lbidulka/elec391_proj/ELEC391_Controls.pdf

## 3.5 DOF SCARA Robot Arm Controls Report

White Paper | Updated - April 13 th
, 2021.

Luke Bidulka - 62893870 ECE, University of BC, Vancouver, Canada Nikita Drozdovs - 93522522 ECE, University of BC, Vancouver, Canada Zachary Chow - 40475931 ECE, University of BC, Vancouver, Canada

Abstract
In this paper, we describe how the control system was designed and simulated for a 3.5 DOF SCARA robot arm.
Section 1 outlines the design goals and requirements. Section 2 describes the detailed controls design of the arm and its subcomponents. The first sub-section of controls is an overview and an introduction to our system. The second sub-section covers PID implementation using custom MATLAB function block, and how we calculated each of the gains. Sub-section 3 is the implementation of the whole controller in Arduino and calculating the ISR frequency, to be chosen as our Simulink sample time. The fourth sub-section explains our PID tuning strategy and the reason we chose that specific method. Sub-section 5 explains how we convert cartesian coordinates into a desired motor angle using IK, and how we convert actual motor position into cartesian coordinates using FK. Our last sub-section describes the algorithm for planning our robot’s path. Section 4 covers the performance of the design.

Nomenclature

CLK | Clock
IK | Inverse Kinematics
FK | Forward Kinematics
Kp | Proportional Gain
Ki | Integral Gain
KD | Derivative Gain

## 1. Design Goals and Overview

There were several customer specified design requirements, constraints, and goals for the control design of this robot arm outlined below. In addition, for the sake of further customer satisfaction and robustness of design in the face of unforeseen implementation challenges, several additional goals were specified.

Requirements:
- 3.5 DOF SCARA robot with wrist and gripper.
- 3 marshmallows on stopped conveyor.
| • Cylindrical (3cm Diameter x 3cm Tall). • Negligible mass & stiffness.
- 3 marshmallows discarded.

- Grab → Move 10 cm → Drop.
- 0% overshoot before gripping.

Constraints:
- 1 Arduino Leonardo.
- Motors operate at or below nominal voltage.

Goals:
- Minimum processing time

Additional Goals:

- Easily modifiable path planning and dynamic code.
- Modularity of design, to allow for different motors.
- Transferable to the real world.

## 2. Control System Design

### 2.1 Overview

The control system design was done in MATLAB and Simulink as shown in Figure 1.

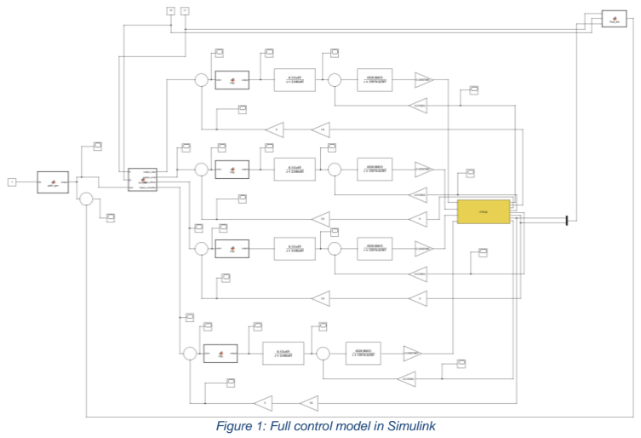
[picture p1: figure]

Figure 1: Full control model in Simulink

The system starts by generating an array of cartesian coordinates and a gripper state -either closed or open, cartesian coordinates define the path that the robot arm will follow. It then outputs those coordinates at a frequency of 0.01 seconds to the Inverse Kinematics MATLAB Function Block, which computes the desired angle in radians for the bicep, forearm, wrist, and the gripper. The desired angle is fed into its respective closed feedback loop, there we compute the motor torque and send it to SimX. In SimX we integrated a full SOLIDWORKS model instead of a simple model as our final iteration to reflect real life hardware more accurately. We also found the PID gains of both simulations to be similar but had to be slightly adjusted, thus it made sense to use the more realistic model.

### 2.2 PID Controller (MATLAB Function)

We designed our own PID controller by using a MATLAB function block. We have four different PID blocks, one for each motor, even though the motors are the same, the required proportional, integral, and derivative gains are different. Figure 2 shows an example of a PID block for the shoulder motor.

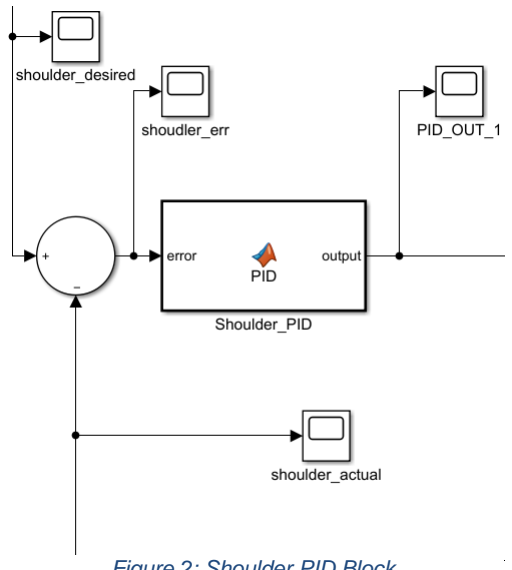
[picture p2: figure]

The input to the PID block is the error, which is just the desired position minus actual position. The code for calculating proportional, integral, and derivative values is shown in Appendix A.

### 2.2.1 PID Gain Calculations

Two of the gains were simple to calculate, for the proportional gain we just had to multiply Kp by the error, and the integral gain is just the sum of errors over time

Figure 2: Shoulder PID Block

multiplied by Ki
, however the derivative gain was bit harder to find. For the derivative gain we decided place a filtering pole and implemented this by having a running sum array that favors the most recent calculation. This was accomplished by first having an array with 4 constant gains, with each term being

(e

−Tau)

modifier∗sample_time
2 | , Tau being the derivative filter constant and modifier
being either 1,3,5 or 7, depending on the term. Then we to find the value that would be multiplied by the recently mentioned constant term, we had computed the slope of error vs sample time →
| error−(previous error)
| Δt and then multiplied it by
Kd. Every value in the running sum array would be shifted to the left by 1, and then the most recent value would be multiplied by the constant term with modifier value being 1, thus having the most impact on the derivative term.

### 2.2.2 PID output limiter

We had to make sure that the output of our PID block stays within the limit of what our motors can handle. In our code, the sum of proportional, integral, and derivative gain was limited to either 5 V or -5 V, this resulted in our motor input voltage to be below 12 V.

### 2.3 Arduino C Code

The code that would replicate the behavior of all our MATLAB function blocks was written in C and compiled in Arduino IDE, the complete code can be seen in Appendix B. In the C code we implemented features such as path planning, inverse kinematics, encoder readings and PID itself. We use the encoder to get an actual joint position, which is used to calculate the error in the PID controller. We also made use of C functionality such as structs and pointers to simplify and minimize the code. Overall, our Arduino C code behaves the same way as the MATLAB function blocks, the code just had to be slightly adjusted to be compatible with C.

### 2.3.1 ISR Frequency

For our MATLAB simulation to be as realistic as possible, we had to compute ISR frequency of our Arduino loop. Even though the Simulink model is continuous, we can specify any discrete sample time of our MATLAB function blocks, thus we can compute and output values at a predictable time interval, which is needed for our PID calculations. However, being able to choose any discrete sample time is not realistic as we need to account for how long our code in C takes to run as if we would make the device in the real world. This was done by counting clock cycles for all our executions, we found this number to be 2823 clock cycles. Our Arduino Leonardo clock frequency is 16 MHz; thus, we can divide 2823 by 16 MHz, and we get 0.000176 seconds, this is our supposed

MATLAB sample time. However, we found that to be too fast to control and we were not able to get a zero-error steady state, thus we added a delay in the Arduino code for 823 Microseconds and brought our sample time down to 0.01 seconds.

### 2.4 Tuning Strategy

We used the same tuning strategy for all our joints and the steps were as follows:
1. Pick a constant destination value, for example go from [0.2 0.15] -> [0.15 0.3]
2. Make all the PID gains equal to zero.
3. Increase Kp to as large as possible while staying within our PID output limit and the error should have as close to steady oscillations as possible, see Figure 3.
a. Note: Our PID output limit is 5 and -5, so that we stay below 12 V as an input to the motors

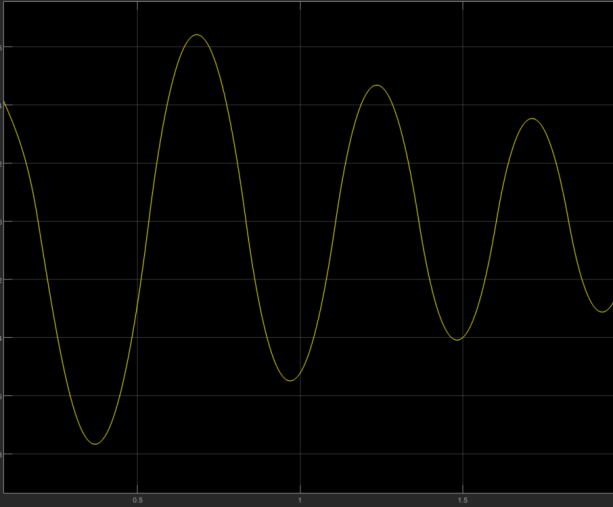
[picture p3: figure]

4. Increase KD until the oscillations go away, so it is critically damped, see Figure 4.

Figure 3: Shoulder Error, Kp=3

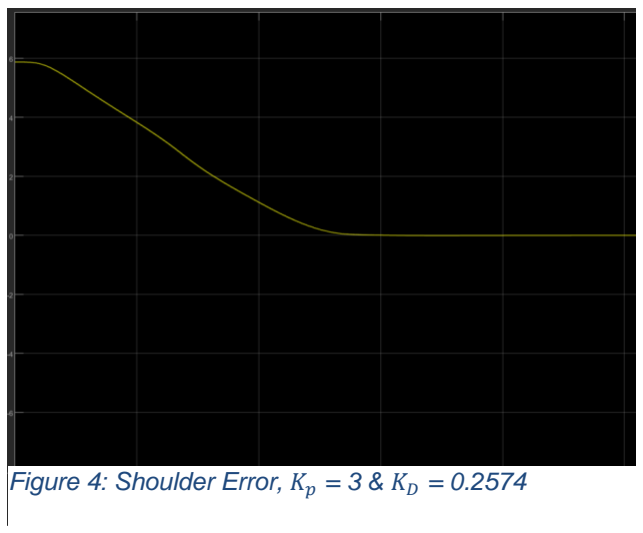
[picture p4: figure]

Figure 4: Shoulder Error, Kp = 3 & KD = 0.2574

5. Look at PID output and if it is below 5V, try to increase Kp and KD and see if we can get critically damped faster.
6. Slightly start increasing Ki until it brings us to our desired setpoint with the number of oscillations desired.
7. Figure 5 shows our final result.

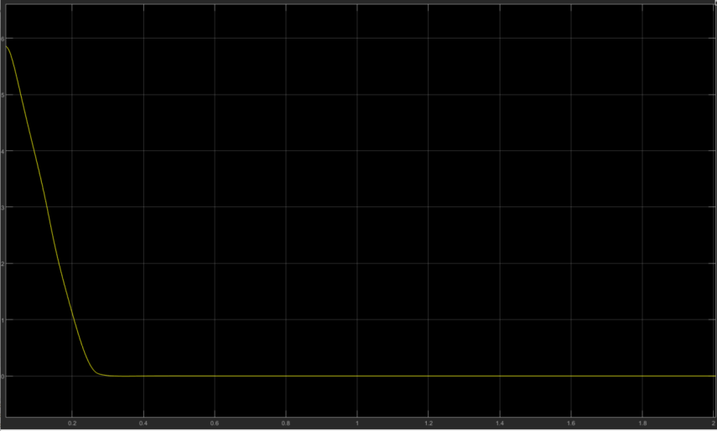
[picture p5: figure]

We decided to use this tunning strategy over the one introduced in class, because we found it more time efficient to co-simulate Simulink and SimX at the start of the project and tune the values according to the simple model, as we had a good idea of what the final product will look like. We also found that this method produced desirable results with less time investment. We were able to meet all the requirements and have a great system response with this method. However, if we would have used the tunning method of linearizing our model, finding our poles and zeros, performing a root locus analysis, and then tunning the gains based of those findings, we could have potentially arrived at values that proved to be more stable. During the tunning of our PID gains, we found that if derivative gain would be slightly increased, as the value approached a pole, our system would become uncontrollable and crash our simulation.

### 2.5 Robot Kinematics

For robot kinematics we implemented two MATLAB Function Blocks, one for inverse kinematics and one for forward kinematics.

### 2.5.1 Inverse Kinematics

See Figure 6 for an inverse kinematics block that receives three inputs - length of the bicep, length of the forearm, and a 1x3 array. The first two elements of the array are x and y coordinates respectively, and the last element is the status of the claw, either open or closed. IK block has 4 outputs, each being a desired

Figure 5: Shoulder tuning result angle for the motors to go to (shoulder, elbow, wrist, and claw). For IK we must compute the desired angle for all 4 joints. See Appendix C for the MATLAB function code.

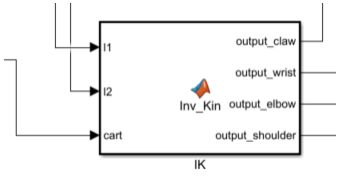
[picture p6: figure]

### 2.5.1.1 Elbow

For the elbow we want to get the right handed solution, thus we take the absolute value of inverse cosine of x

2 + y

2 − (lengtℎ of forearm)

2 −
(lengtℎ of bicep)

2 divided by 2 ∗ (lengtℎ of forearm ∗ (lengtℎ of bicep). This gives us a desired elbow angle, but we need the angle of the motor which is, due to the gearbox, 35 times less, so we multiply the result of the previous calculation by 35 to get the desired motor angle.

### 2.5.1.2 Shoulder

For the shoulder, the output angle is (gamma − beta) ∗ 35, with gamma being inverse tan of y/x, and beta being inverse tan of
(lengtℎ of forearm) ∗ sin(angle of elbow) divided by
(lengtℎ of bicep) − (lengtℎ of forearm) ∗ cos(angle of elbow).

### 2.5.1.3 Wrist

We wanted our wrist to always face perpendicular to the table, so that we can just move in a straight line to pick up the marshmallow. Thus the desired angle ends up being −(angle of sℎoulder) −
(angle of forearm) + (angle of conveyor) ∗ 2 ∗ π/360, and then we once again multiply by 35.

Figure 6: Inverse Kinematics MATLAB Block

### 2.5.1.4 Claw

The claw simply has 2 states, it is either open or closed, if the state passed into IK block is closed, then we output an angle of 0.3 radians and if the claw is supposed to be open that the output angle is -0.6 radians. We did not use a gearbox for the claw, because we found it to be way too unstable to control, and the only way to make it work with the gearbox was to make the weight over 130 grams, which was unreasonable.

### 2.5.2 Forward Kinematics

See Figure 7 for a forward kinematics block that receives 3 inputs - length of the bicep, length of the forearm, and a 1x2 array. The two elements of the array are bicep and forearm position, respectively. FK block has 1 output, which is a 1x2 array of x and y cartesian position of the arm. See Appendix D for the MATLAB function code.

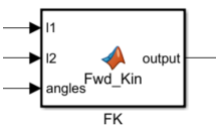
[picture p7: figure]

### 2.5.2.1 Computation

To find the output cartesian coordinates, first we must divide both input angles by 35 to account for the gearbox. Then we can compute x the following way (lengtℎ of bicep) ∗ cos(angle of bicep) +
(lengtℎ of elbow) ∗ cos((angle of bicep) + (angle of elbow)). We can find y the exact same way but replace cosine with sine. Then we output an array of x & y.

### 2.6 Path Planning

For path planning we implemented a MATLAB Function Block that computes the whole path of the arm and then outputs a coordinate on each positive clock edge, so every 0.001 seconds. See Appendix E for the code.
Path planning array is constructed by defining a sequence of events that needs to happen. For our path we decided to have 6 possible destinations: first garbage point, first marshmallow point, second garbage point, second marshmallow point, third garbage

Figure 7: Forward Kinematics MATLAB Block point, and third marshmallow point. Each marshmallow is evenly spaced on a 30 cm long conveyor and their respective garbage point is at a straight-line distance of 10 cm. See Figure 8.

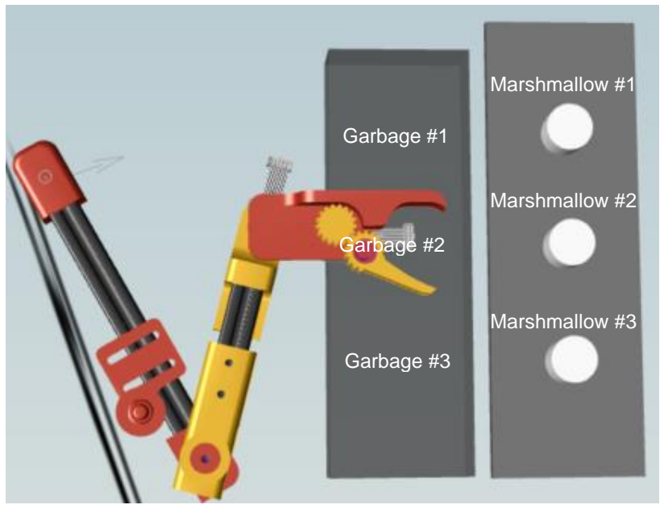
[picture p8: figure]
Marshmallow #1; Garbage #1; Marshmallow #2; Garbage #2; Marshmallow #3; Garbage #3

The path that we chose for our arm to move follows the following pattern:
Garbage #2 (starting position) → Garbage #1 → Marshmallow #1 → Garbage #1 → Garbage #2 → Marshmallow #2 → Garbage #3 → Marshmallow #3 → Garbage #3 → Garbage #2 (idle position)

### 2.6.1 Path Planning Algorithm

Our path planning algorithm resembles a state machine, as in we keep track of our current and next position and we iterate through these coordinates by incrementing an event counter that dictates our switch case statement. When the arm moves to any point that is not Marshmallow #1/2/3, we simply populate the path array with 1000 equally spaced points in a straight line from current to final position. This is done so that we can control the speed of the arm by increasing or decreasing the number of points in between our 2 positions. When the arm is on its way to Marshmallow #1/2/3, we slow down as we approach the marshmallow so that we have the most precision and zero overshot once we are ready to grab the marshmallow. This is done by performing a limited exponential interpolation, so that when we get closer to the marshmallow our division of current vs next point gets smaller and smaller until it hits a predefined limit. When we arrive at our destination, we wait for about 0.5 seconds before moving onto

Figure 8: Robot Arm at Second Garbage Point the next task, this delay is because as we have seen from section 1.4 it takes about 0.3 seconds for the joint to not have any overshoot.

## 3. Performance Analysis

For easy of reference, the requirements, constraints, and goals outlined in Section 1 are repeated here.

Requirements:
- 3.5 DOF SCARA robot with wrist and gripper
- 3 marshmallows on stopped conveyor
- Cylindrical (3cm Diameter x 3cm Tall)
- Negligible mass & stiffness
- 3 marshmallows discarded
- Grab → Move 10 cm → Drop
- 0% overshoot before gripping

Constraints:
- 1 Arduino Leonardo
- Motors operate at or below nominal voltage

Goals:
- Minimum processing time

Additional Goals:

- Easily modifiable, dynamic path planning code
- Modularity of design, to allow for different motors
- Transferable to the real world

Considering the controls design of the arm against them outlines, we can see that all of them are satisfactory met. In our SimX design we have 3 marshmallows stopped on a conveyor belt, with a garbage disposal point exactly 10 cm away from the respective marshmallow. We can efficiently approach every marshmallow, grab them and discard them. Figure 9 shows the error of the output from FK compared to desired position output from path planning MATLAB block, with y axis being error in m (from 0.01 to -0.01) and x axis being time in seconds. The figure shows first 3.5 seconds of the simulation, that being a path of Garbage #2 → Garbage #1 → Marshmallow #1 and close the claw to grab it.

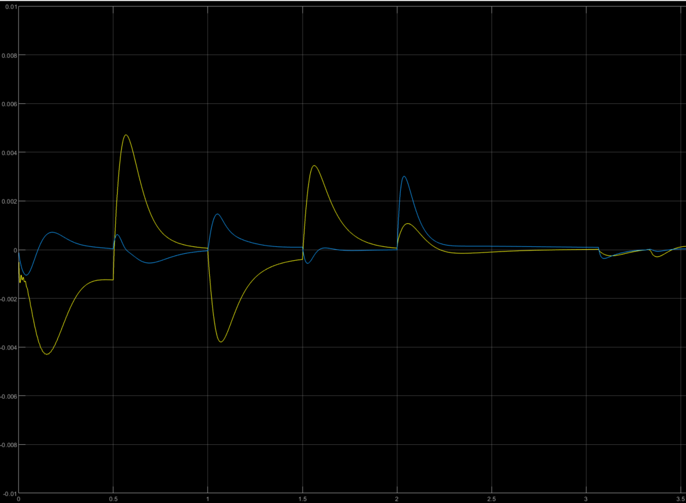
[picture p9: figure]

As we can see the error is at 0.005 meters or 0.5 cm at its worst during the movement from Garbage #2 → Garbage #1, but around 3 seconds when we approach the first marshmallow the error is around 1.5 ∗ 10⁻⁴ meters or 0.15 mm, which can be considered negligible. Thus, showing that we have 0% overshoot when grabbing the marshmallow.
The design also follows all the constraints given to us, we are only using 1 Arduino Leonardo board, as seen from our 16 MHz clock frequency sued to calculate our sample time. Also, as can be seen in Appendix A, our PID code has an output limit which makes sure that our motors operate below a nominal voltage of 12 V.

Our design also achieves a goal of having a minimum processing time. This was achieved by picking the maximum gain values that would not result our PID output constantly being at the limit. Also, because our code includes a time division parameter than regulates the speed of our simulation by affecting the number of desired points in between each destination, we were able to test and come up with the most optimal number that ensured we maintained accuracy while speeding up the simulation as much as possible.
Our path planning computes the position of each marshmallow and garbage point based on the position and angle of the conveyor belt. Thus, our code was quick to modify and test when we were adjusting our conveyor location multiple times over the course of the project. Additionally, as mentioned before our PID code has an output limiter which ensures we stay below the nominal voltage, so if we decided to switch motors at the end of the project, we would just have to adjust the PID output limit and not worry about going over the new nominal voltage. Our C code is written as if we were creating this design in real life and flashing an Arduino Leonardo, such that it includes path planning, IK, FK, PID, object-like structs for each motor, and we make

Figure 9: Cartesian error of actual vs desired position in meters use of the encoders to get our actual motor position. With these facts in mind, the additional goals are deemed to be met.

However, there is an immediate improvement that could be made to the design. As we saw in Figure 9, there is overshoot when we try to move in between garbage points, that is because we do not try to slow down as we approach the garbage point, since that was not a requirement, meaning we chose to maintain speed over accuracy. This could be fixed if we selected motors with higher nominal voltage so that we can increase the value of Kp, Ki

, and KD, this would allow us to have a snappier response and get to our steady state faster.

## Appendix A – MATLAB PID Code

MATLAB code for the PID of the shoulder, the other joints are exactly the same just with different gain values.

function output = PID(error)
persistent pid_integrator pid_prev_error pid_lim_min pid_lim_max sample_time Kp Ki Kd Tau diff_array diff_mult

if isempty(pid_integrator)
pid_integrator = 0;
pid_prev_error = 0;
pid_lim_min = -5;
pid_lim_max = 5;
sample_time = 0.001;
Kp = 3;
Ki = 0.001;
Kd = 0.2574;
Tau = 600;
diff_array = zeros(1,4);
diff_mult = [exp(-Tau)^(7*sample_time/2) exp(-Tau)^(5*sample_time/2) exp(-Tau)^(3*sample_time/2) exp(-Tau)^(sample_time/2)]; end

%Proportional
proportional = Kp*error;

%Integral
pid_integrator = pid_integrator + 0.5*Ki*sample_time*(error + pid_prev_error);

%Derivative
diff_array(4) = Kd*(error - pid_prev_error)/sample_time;
pid_differentiator = 0;
for i = 1:length(diff_array)
pid_differentiator = pid_differentiator + (diff_array(i)*diff_mult(i)); end

diff_array = circshift(diff_array,[0, -1]);
pid_prev_error = error;

output = proportional + pid_integrator + pid_differentiator;

if output > pid_lim_max
output = pid_lim_max;
elseif output < pid_lim_min output = pid_lim_min;
end
end

## Appendix B – Arduino Controller Code

Arduino code written in C for the control of all motors. This code includes a source and a header file.
Source File:

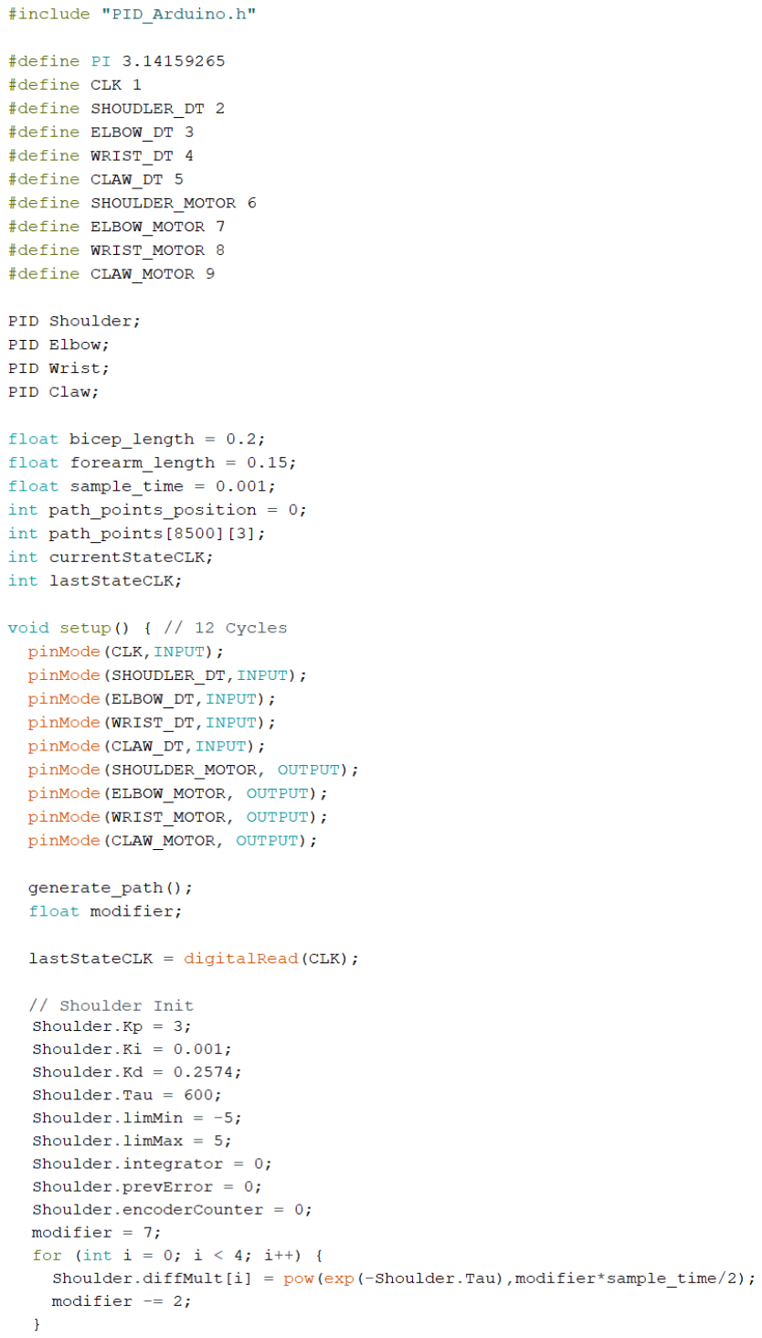
[picture p10: figure]

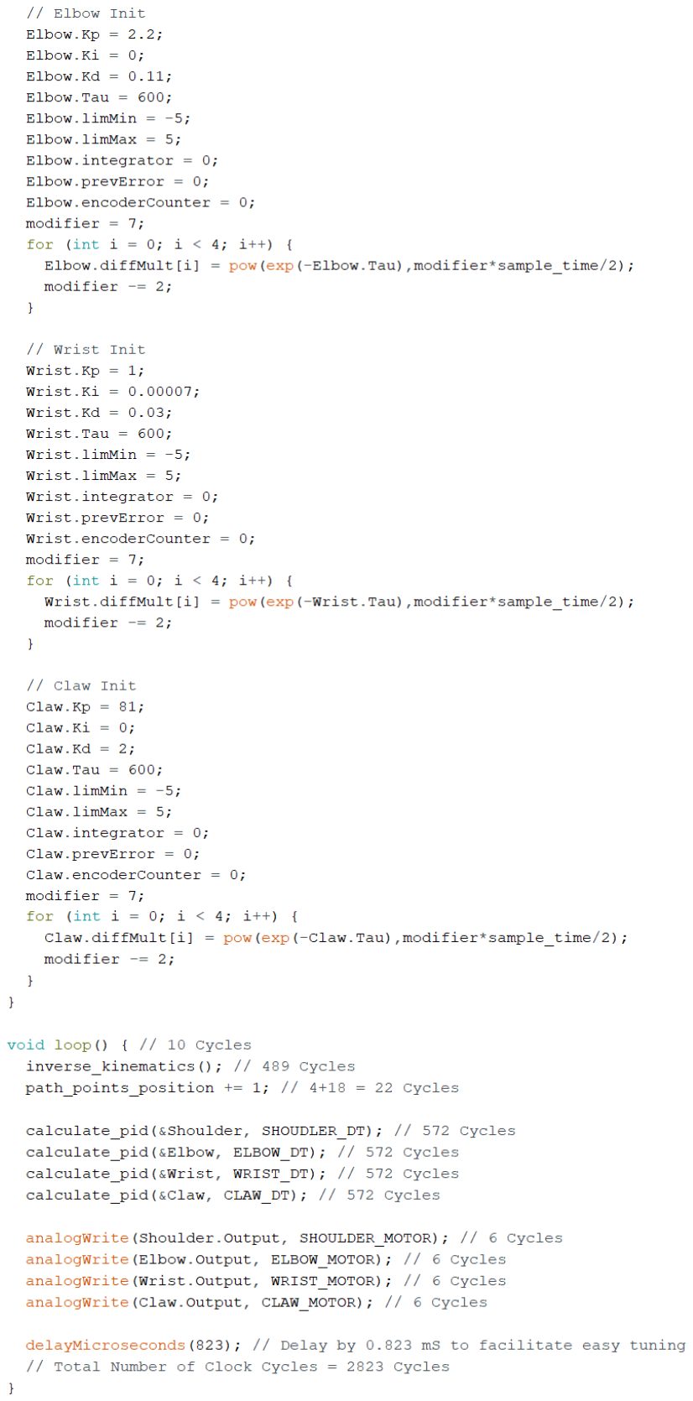
[picture p11: figure]
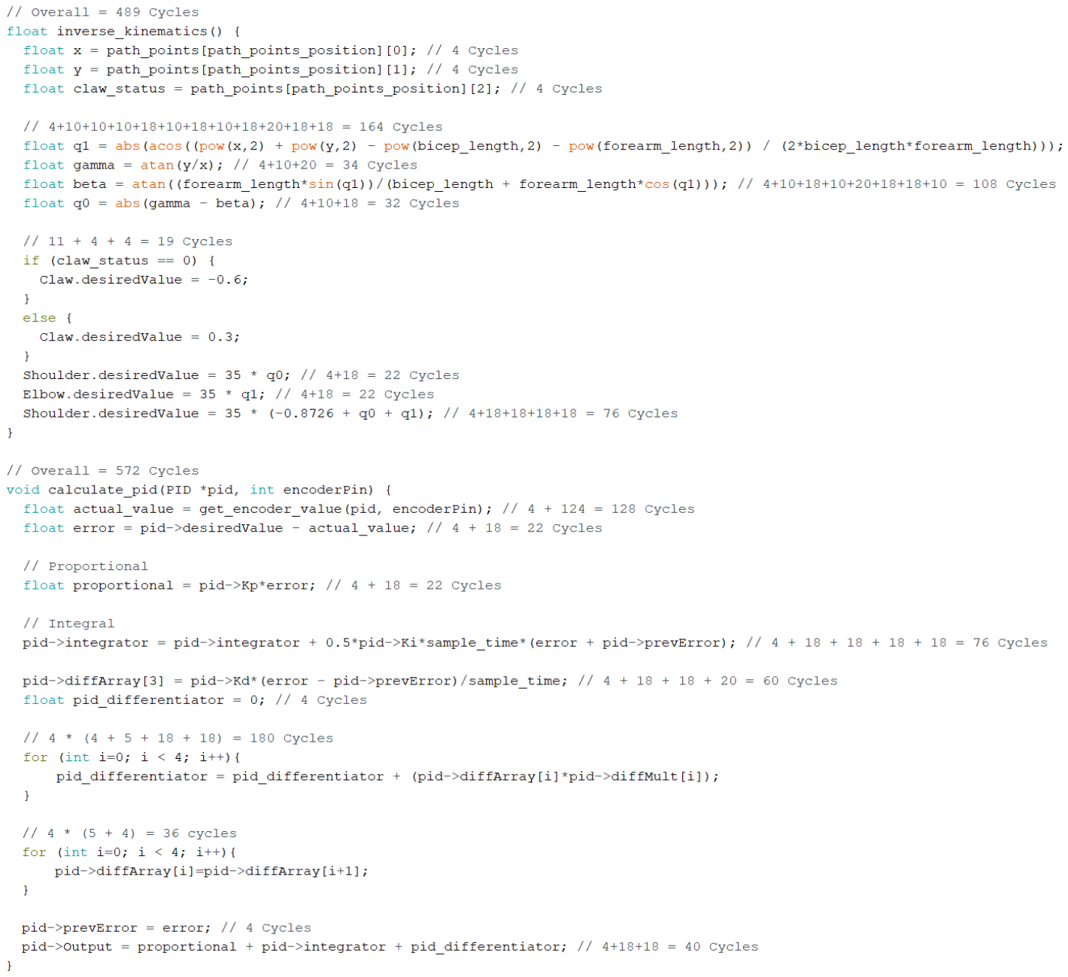
[picture p12: page 16]

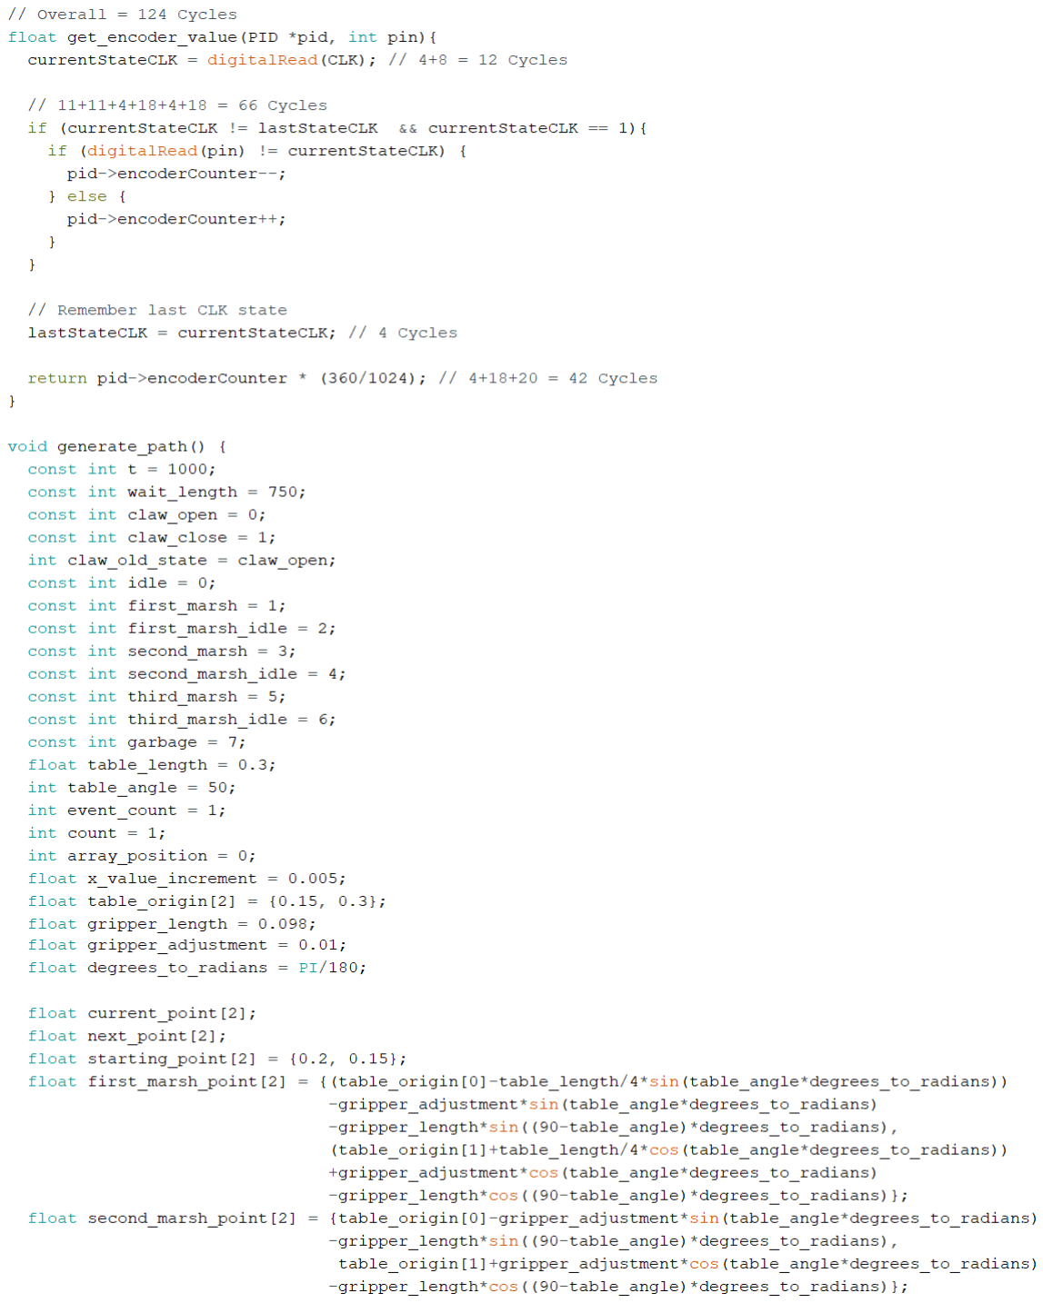
[picture p13: figure]
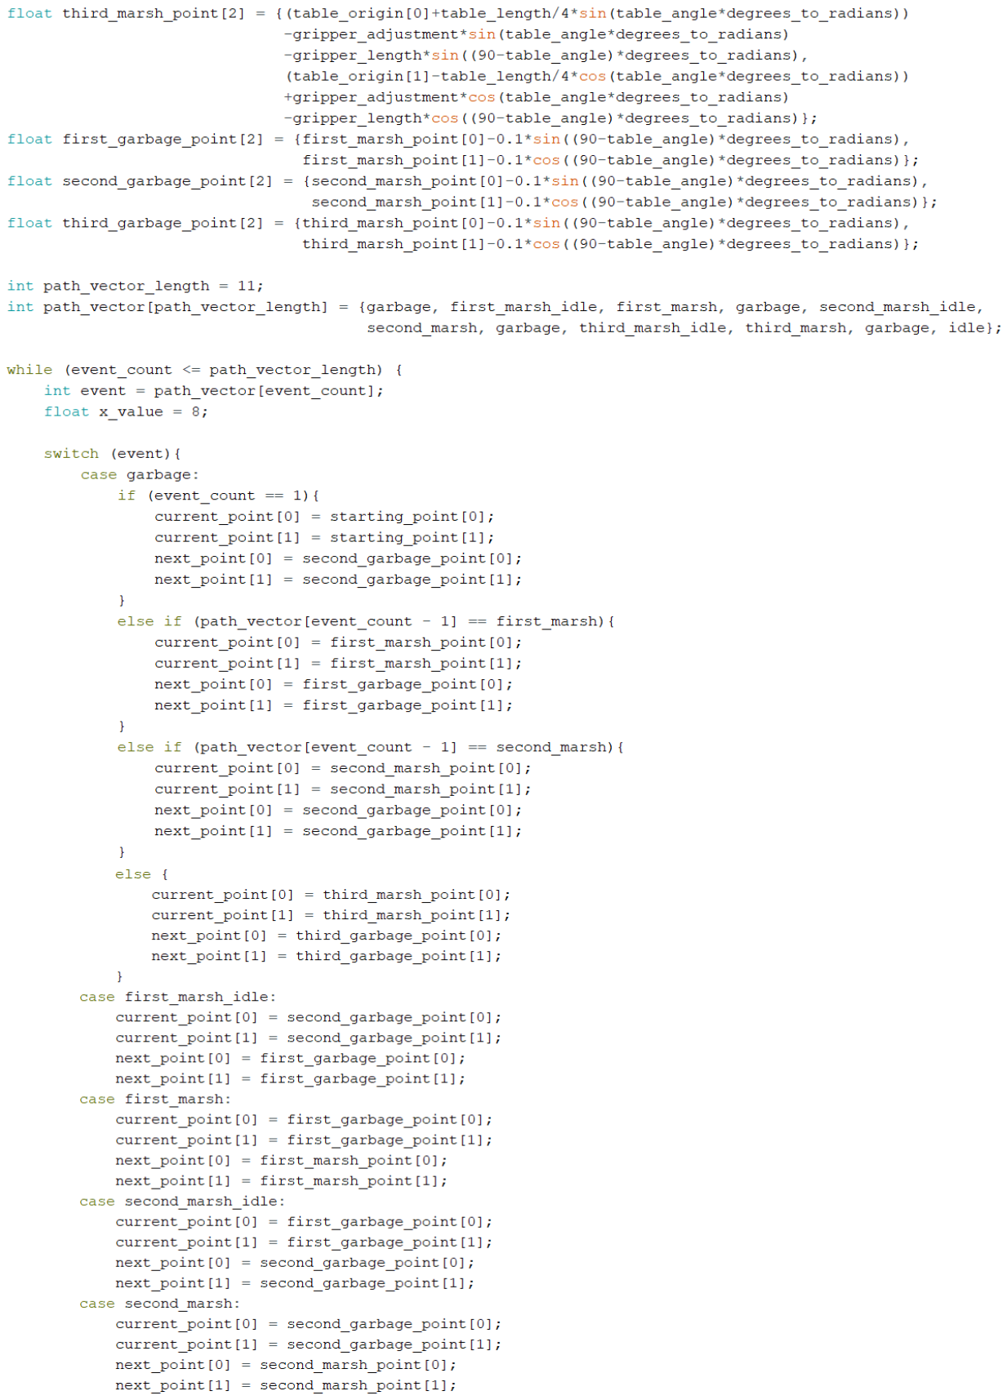
[picture p14: page 18]
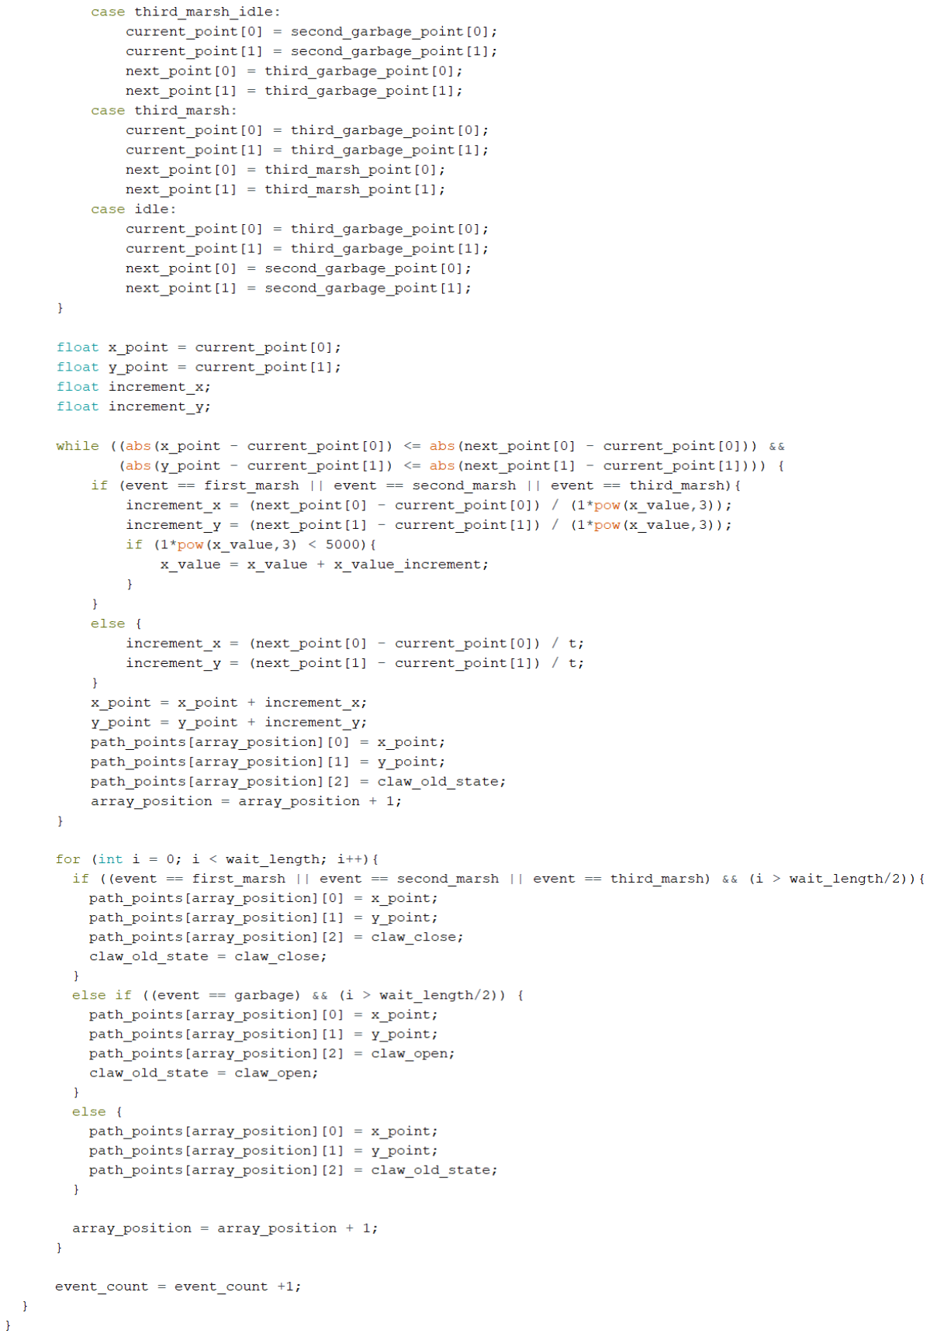
[picture p15: page 19]

Header File:

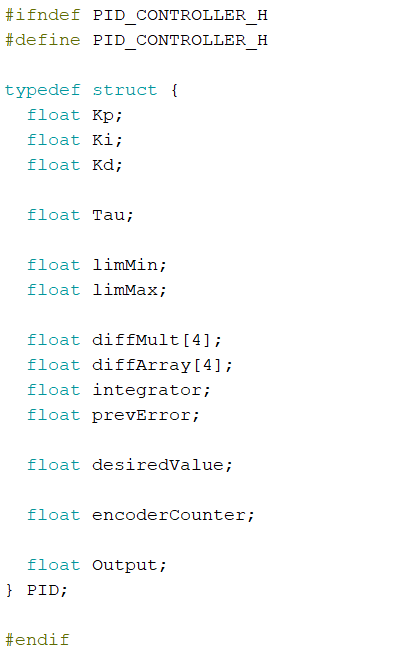
[picture p16: figure]

## Appendix C – MATLAB IK Code

MATLAB code for the IK

% Inv Kinematics
function [output_claw,output_wrist,output_elbow,output_shoulder] = Inv_Kin(l1, l2, cart)
x = cart(1); % Task-space x coord
y = cart(2); % Task-space y coord

% Get q1 first, need it to calculate q0. We will always % take the "right-handed" solution where q1 is (+). q1 = abs(acos((x^2 + y^2 - l1^2 - l2^2)/(2*l1*l2)));

% Get q0
gamma = atan(y/x);
beta = atan((l2*sin(q1))/(l1 + l2*cos(q1)));

q0 = gamma - beta;

% Ouput our angle vector
if cart(3) == 0
output_claw = -0.6;
else
output_claw = 0.3;
end
output_wrist = 35 * (-q0 - q1 + 70*(2*3.1415/360)); output_elbow = 35 * q1;
output_shoulder = 35 * q0;

end

## Appendix D – MATLAB FK Code

MATLAB code for the FK

% Fwd Kinematics
function output = Fwd_Kin(l1, l2, angles)

q0 = angles(1) / 35; % Configuration-space shoulder angle q1 = angles(2) / 35; % Configuration-space elbow angle

% Get task-space coordinates
x = l1*cos(q0) + l2*cos(q0+q1);
y = l1*sin(q0) + l2*sin(q0+q1);

% Output the task-space cartesian coordinats output = [x;y];

end

## Appendix C – MATLAB Path Planning Code

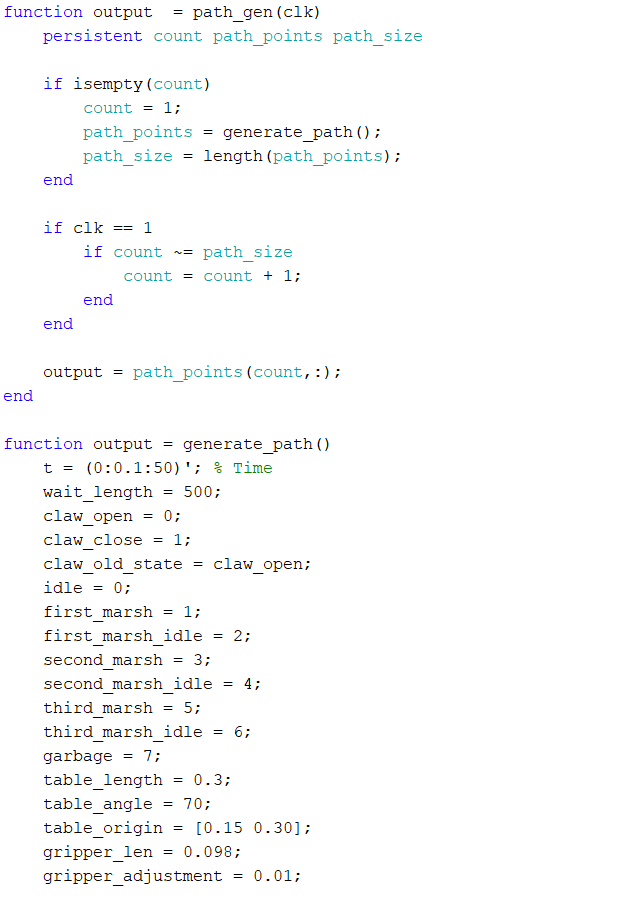
[picture p17: figure]

MATLAB code for path planning, the output of path_gen is every 0.001 seconds.

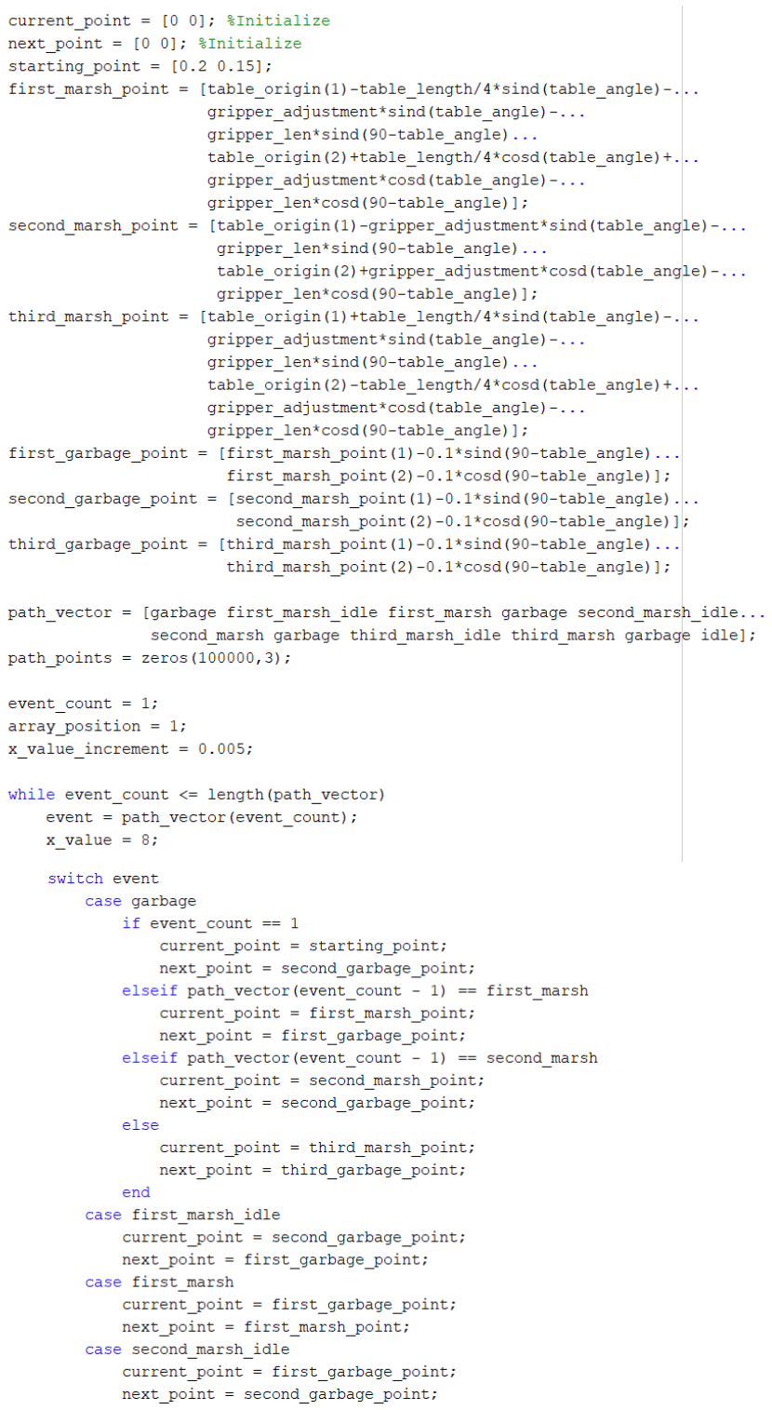
[picture p18: figure]
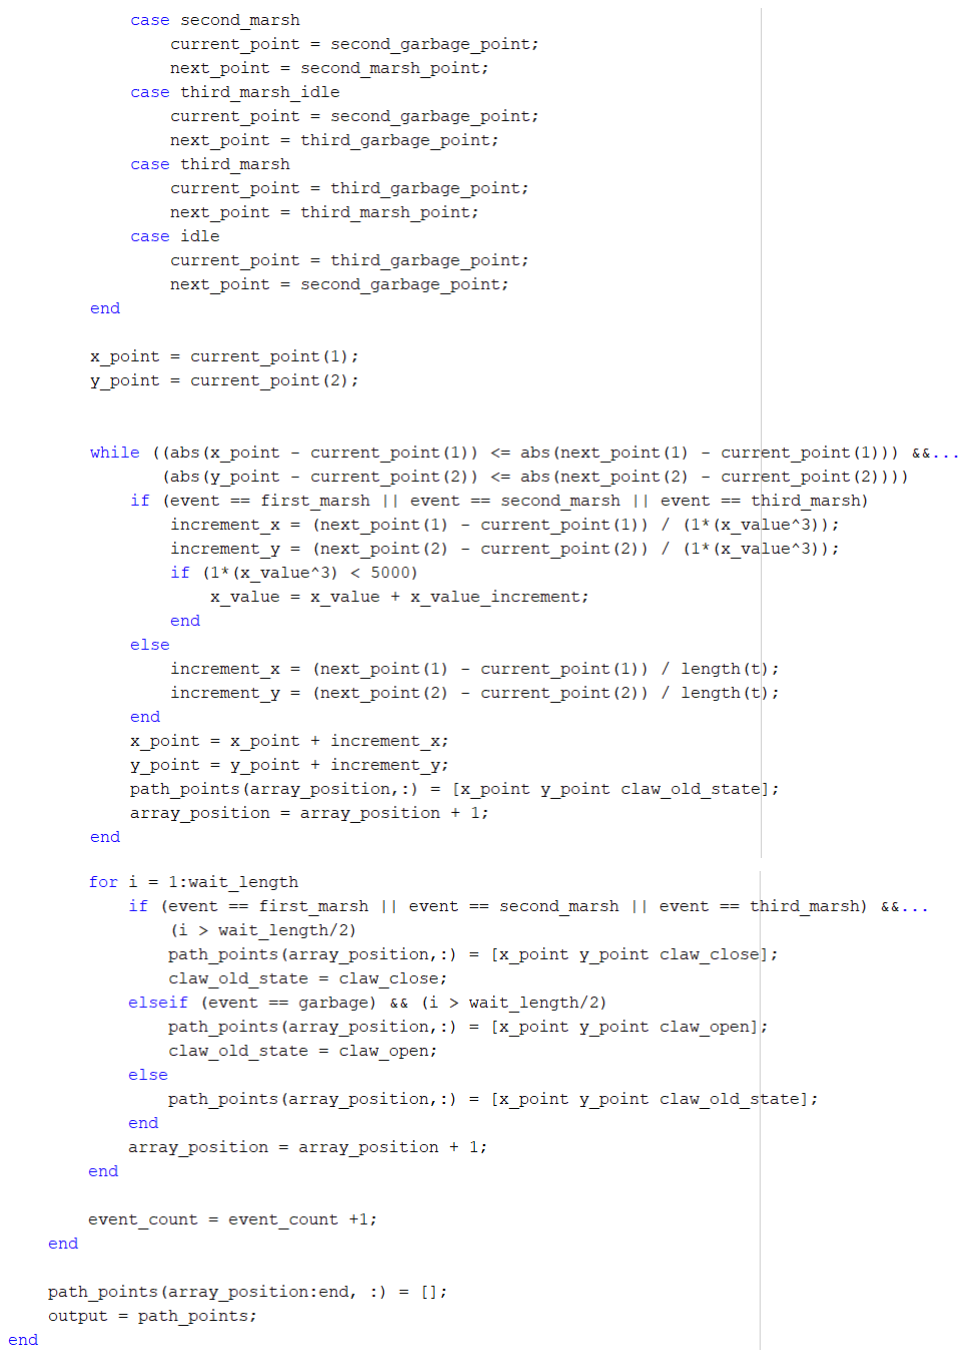
[picture p19: page 23]
