lbidulka/elec391_proj/Mech/Arm_Components/GRIPPER_DCX22S_22mm_assembly.stl

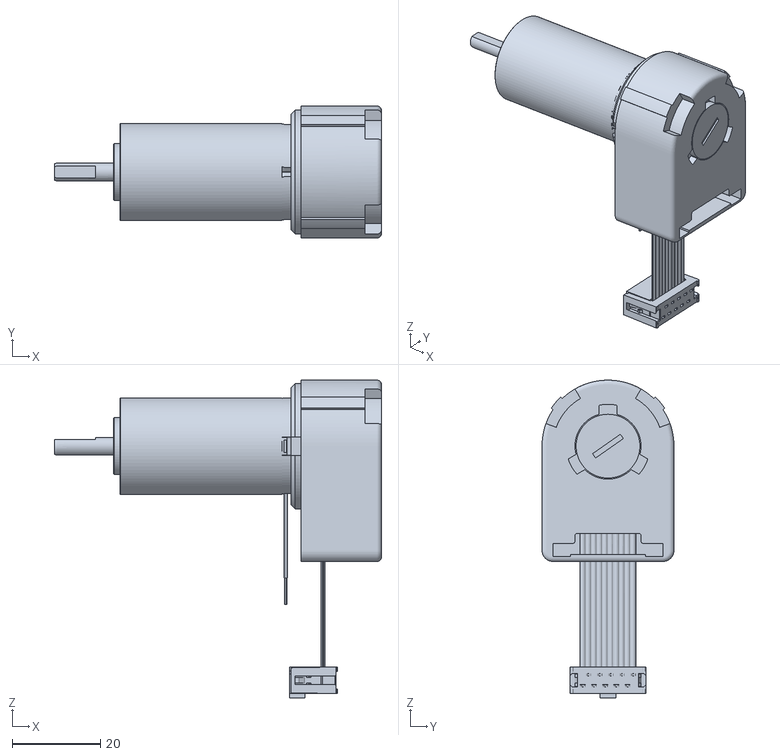
[picture p20: CAD file, 2021-04-18]
Mech/Arm_Components/GRIPPER_DCX22S_22mm_assembly.stl
74.3 x 30.0 x 72.2
