lbidulka/elec391_proj/Mech/Arm_Components/DCX22S_22mm_assembly.stl

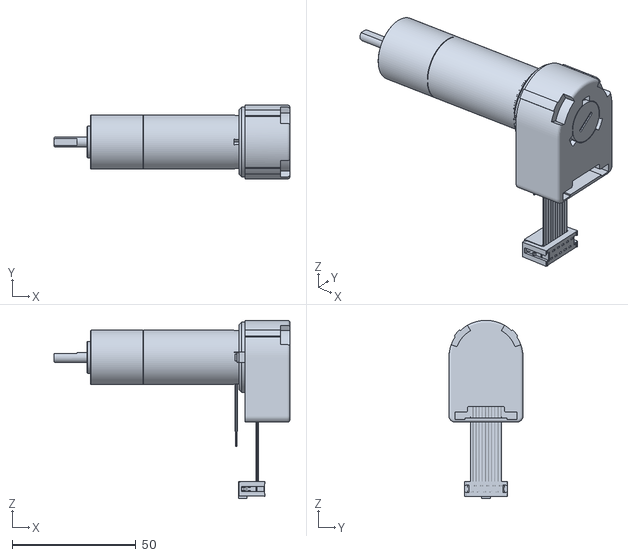
[picture p21: CAD file, 2021-04-18]
Mech/Arm_Components/DCX22S_22mm_assembly.stl
95.5 x 30.0 x 72.2
