lbidulka/elec391_proj/Mech/Arm_Components/forearm-socket.stl

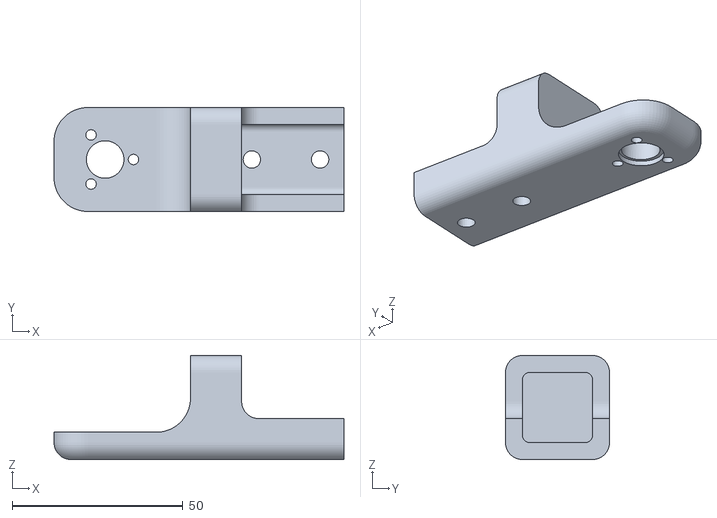
[picture p22: CAD file, 2021-04-18]
Mech/Arm_Components/forearm-socket.stl
85.0 x 30.5 x 30.5
