lbidulka/elec391_proj/Mech/simulations/shoulder-base-coupler-sim.SLDPRT

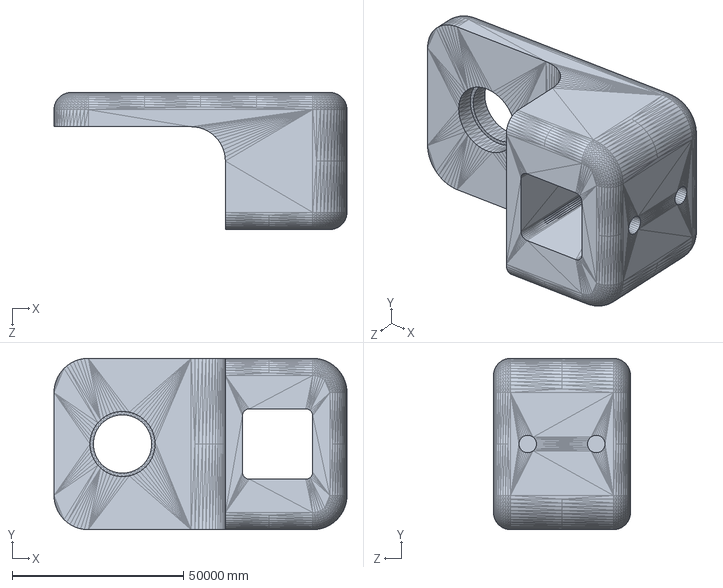
[picture p23: CAD file, 2021-04-18]
Mech/simulations/shoulder-base-coupler-sim.SLDPRT
85500.0 x 50000.0 x 40000.0 mm
