lbidulka/elec391_proj/Mech/Arm_Components/finger-drive-gear.stl

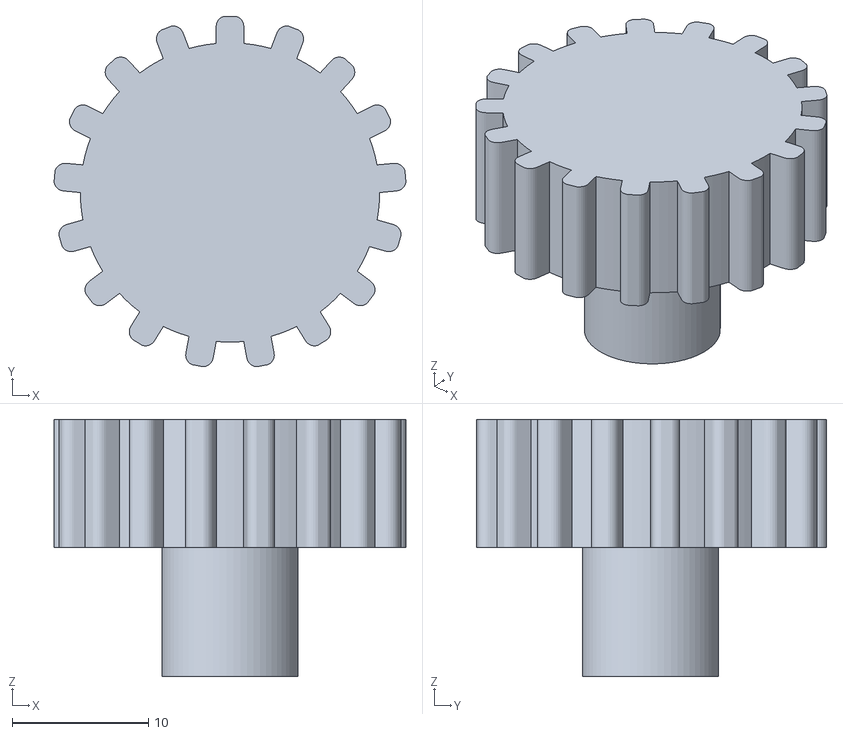
[picture p24: CAD file, 2021-04-18]
Mech/Arm_Components/finger-drive-gear.stl
25.9 x 25.8 x 18.9
