lbidulka/elec391_proj/Mech/Arm_Components/shoulder-base-coupler.stl

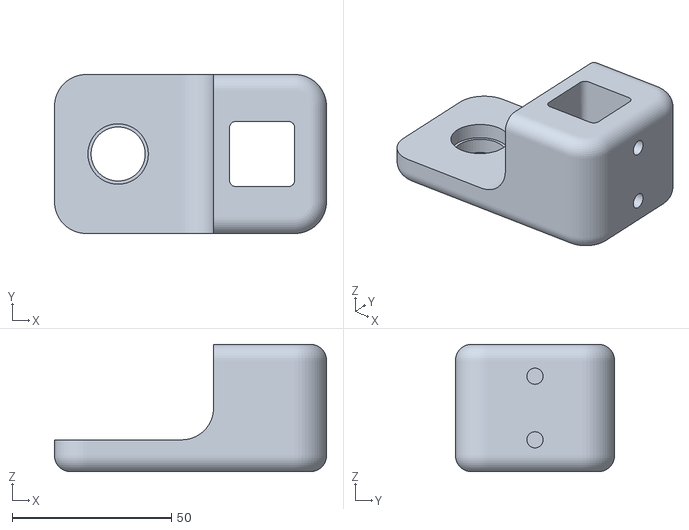
[picture p25: CAD file, 2021-04-18]
Mech/Arm_Components/shoulder-base-coupler.stl
85.5 x 50.0 x 40.0
