lbidulka/elec391_proj/Mech/Arm_Components/bicep-shoulder_mount.stl

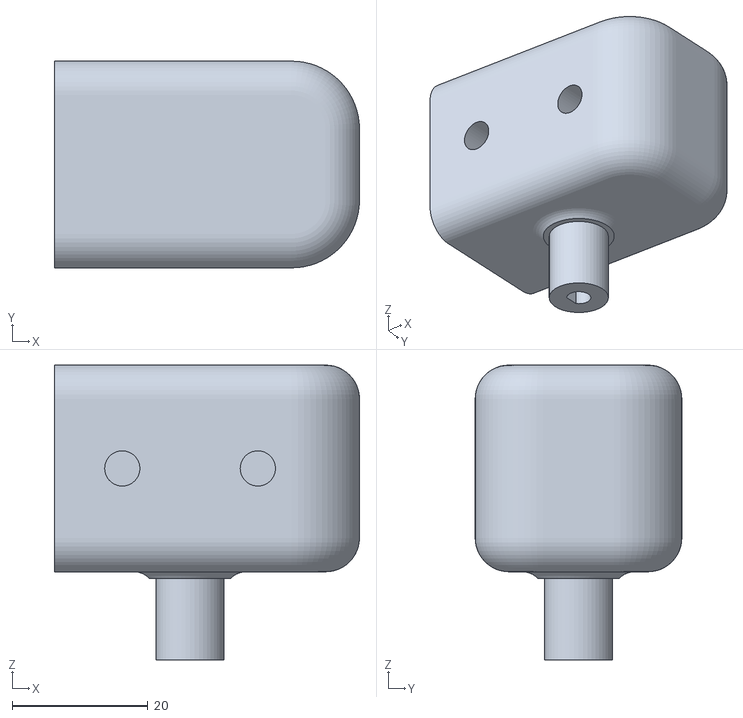
[picture p26: CAD file, 2021-04-18]
Mech/Arm_Components/bicep-shoulder_mount.stl
45.0 x 30.5 x 43.5
