lbidulka/elec391_proj/Mech/Arm_Components/tensioner.stl

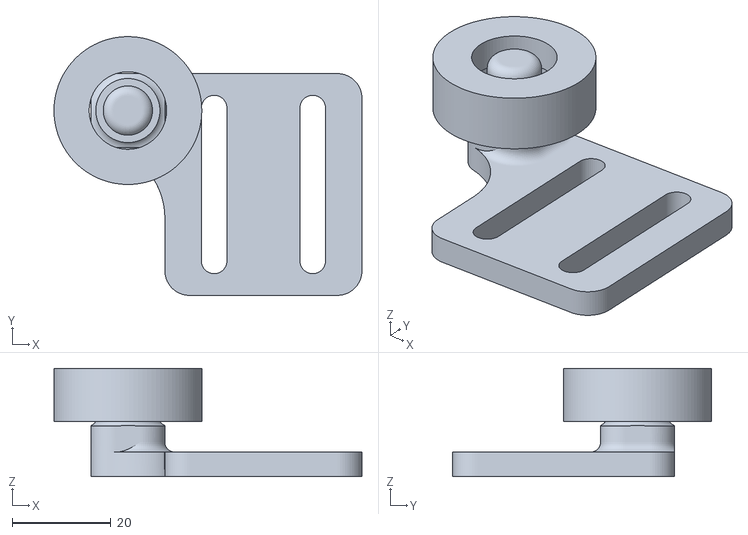
[picture p27: CAD file, 2021-04-18]
Mech/Arm_Components/tensioner.stl
62.5 x 52.5 x 22.0
