lbidulka/elec391_proj/Mech/Arm_Components/bicep.stl

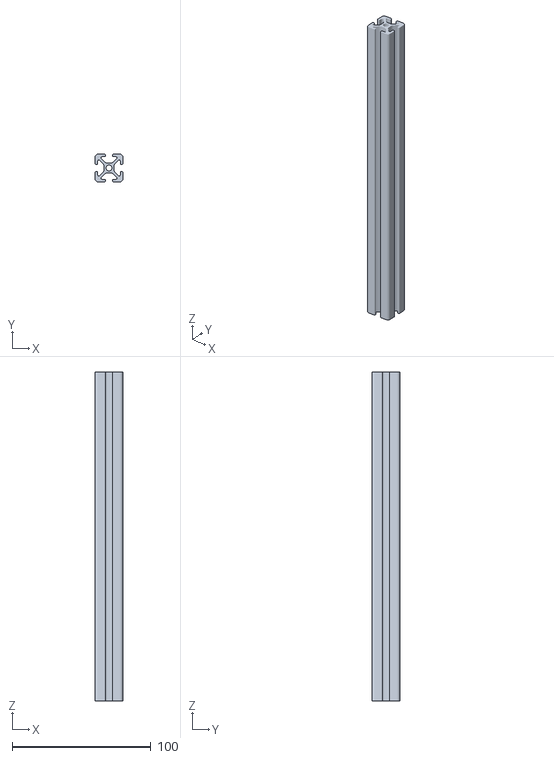
[picture p28: CAD file, 2021-04-18]
Mech/Arm_Components/bicep.stl
20.0 x 20.0 x 237.5
