lbidulka/elec391_proj/Mech/Arm_Components/bicep-elbow-socket.stl

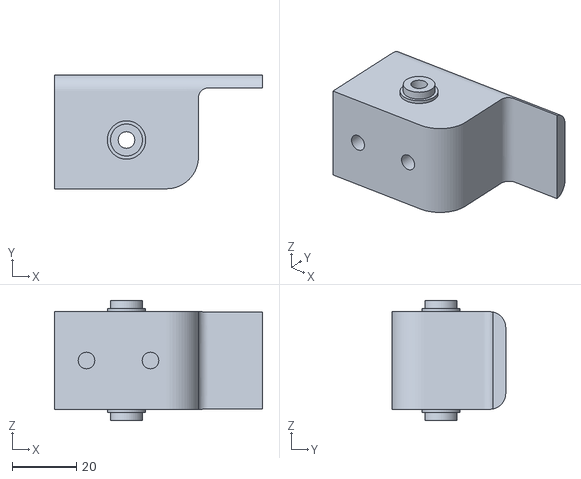
[picture p29: CAD file, 2021-04-18]
Mech/Arm_Components/bicep-elbow-socket.stl
65.0 x 35.5 x 37.5
