lbidulka/elec391_proj/Mech/Arm_Components/elbow-joint-mount-bot.stl

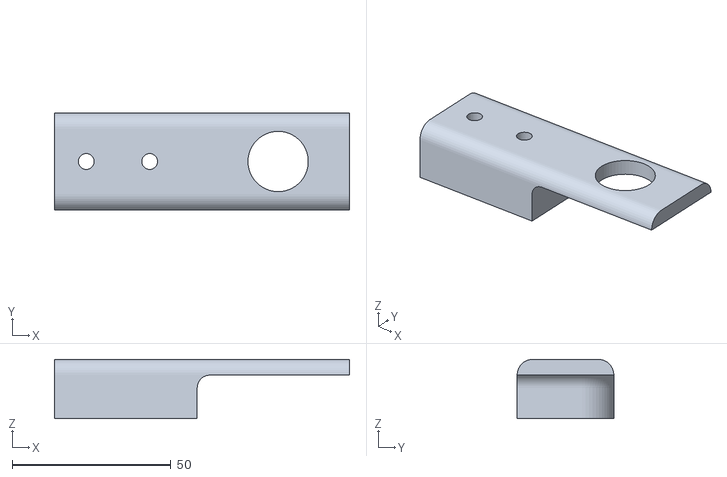
[picture p30: CAD file, 2021-04-18]
Mech/Arm_Components/elbow-joint-mount-bot.stl
93.0 x 30.5 x 18.8
