lbidulka/elec391_proj/Mech/Arm_Components/forearm.stl

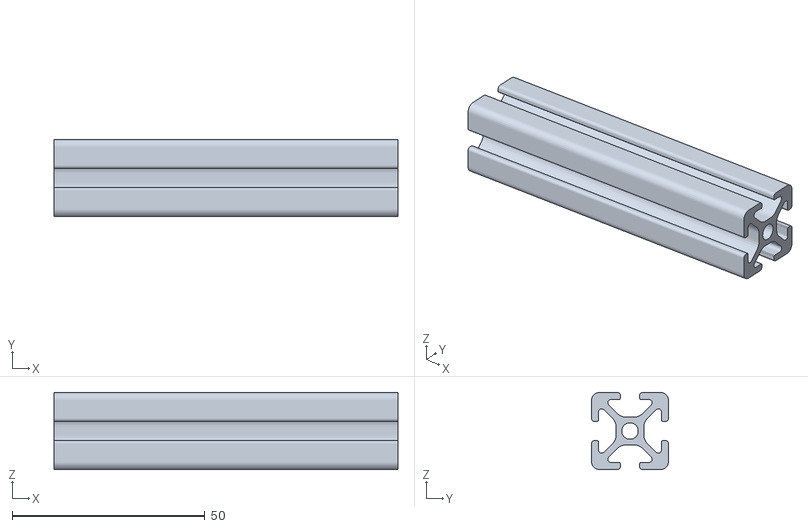
[picture p31: CAD file, 2021-04-18]
Mech/Arm_Components/forearm.stl
89.3 x 20.0 x 20.0
