lbidulka/elec391_proj/Mech/Arm_Components/elbow-joint-mount-top.stl

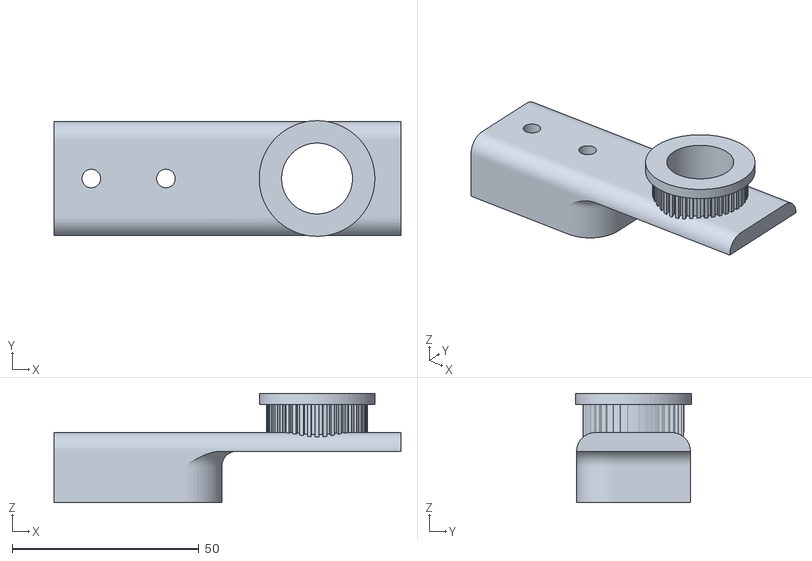
[picture p32: CAD file, 2021-04-18]
Mech/Arm_Components/elbow-joint-mount-top.stl
93.0 x 31.0 x 29.3
