lbidulka/elec391_proj/Mech/Arm_Components/gripper-palm.stl

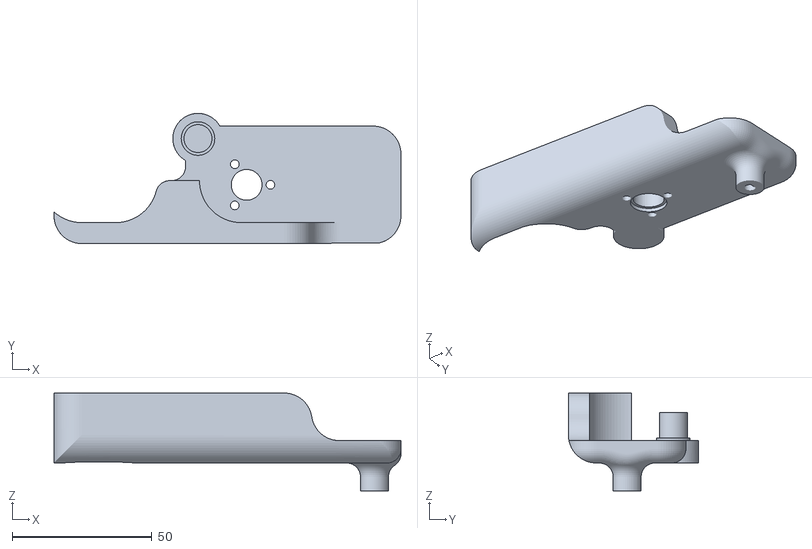
[picture p33: CAD file, 2021-04-18]
Mech/Arm_Components/gripper-palm.stl
124.0 x 46.5 x 35.0
