lbidulka/elec391_proj/Mech/Arm_Components/finger.stl

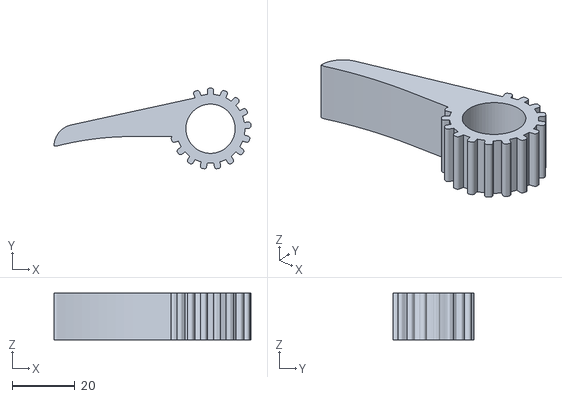
[picture p34: CAD file, 2021-04-18]
Mech/Arm_Components/finger.stl
62.9 x 25.8 x 15.0
