lbidulka/elec391_proj/(commit log)

2021-04-08 adding gears
2021-04-09 Added gearboxes, bad tuning
2021-04-10 Created full SimX model
    [DCX22S_22mm_assembly.stl, bicep-elbow-socket.stl, bicep-shoulder_mount.stl, bicep.stl, elbow-joint-mount-bot.stl, elbow-joint-mount-top.stl, forearm-wrist.stl, forearm.stl]
2021-04-10 Finished arduino code
2021-04-10 new gripper and tensioner
    [finger-drive-gear.stl, finger.stl, forearm-wrist.stl, gripper-palm.stl, tensioner.stl]
2021-04-13 swapped wrist motor in SimX
    [GRIPPER_DCX22S_22mm_assembly.stl, bicep-elbow-socket.stl, bicep-shoulder_mount.stl, elbow-joint-mount-bot.stl, elbow-joint-mount-top.stl, forearm-socket.stl, forearm-wrist.stl, shoulder-base-coupler-sim.SLDPRT]
